rome2/midiswitch/board/MIDI Switch.kicad_pcb

## KiCad design board/MIDI Switch.kicad_pcb (2016-09-18, last stored version)

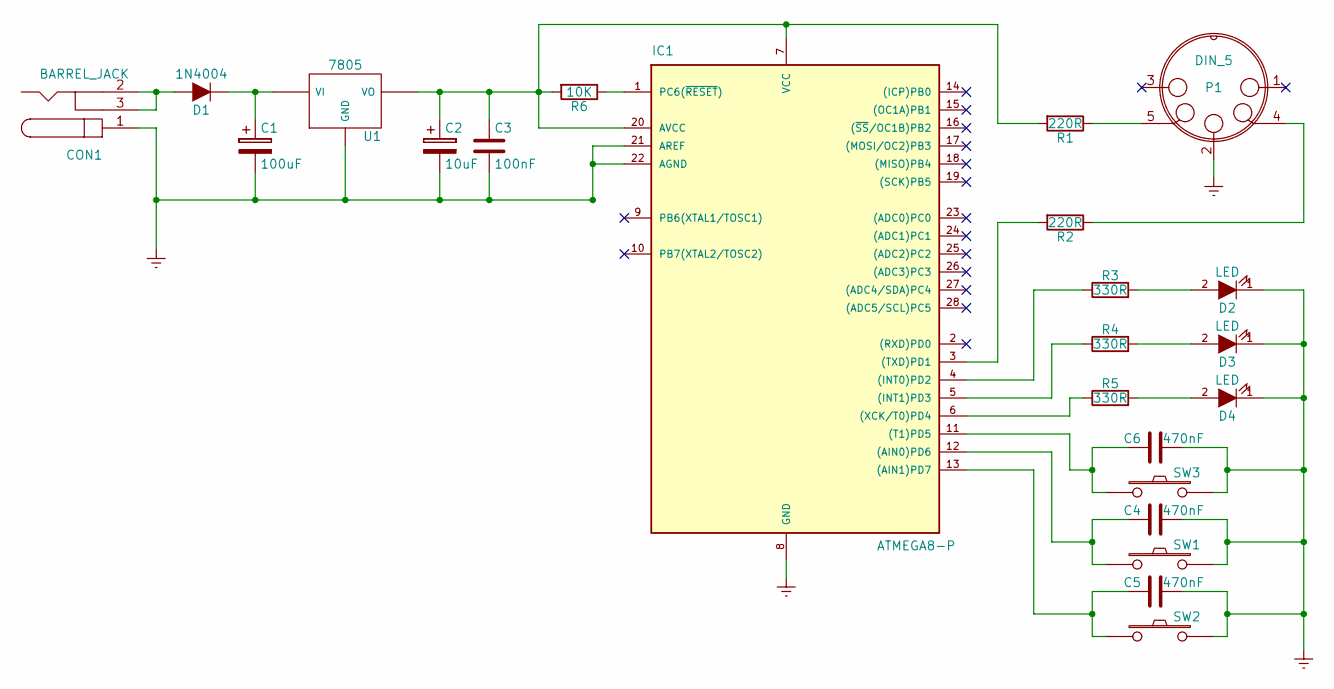
[picture p5: schematic MIDI Switch.sch]

Parts:
C1: 100uF; C_Radial_D8_L13_P3.8
C2: 10uF; C_Radial_D5_L11_P2.5
C3: 100nF; C_Disc_D6_P5
C4, C5, C6: 470nF; C_Disc_D6_P5
CON1: BARREL_JACK
D1: 1N4004; Diode_DO-41_SOD81_Horizontal_RM10
D2, D3, D4: LED; LED-5MM
IC1: ATMEGA8-P; DIP-28_W7.62mm
P1: DIN_5; Pin_Header_Straight_1x05
R1, R2: 220R; Resistor_Horizontal_RM10mm
R3, R4, R5: 330R; Resistor_Horizontal_RM10mm
R6: 10K; Resistor_Horizontal_RM10mm
SW1, SW2, SW3: SW_PUSH
U1: 7805; TO-220

Connections:
GNDREF: C1.2, C2.2, C3.2, C4.2, C5.2, C6.2, CON1.1, D2.1 (K), D3.1 (K), D4.1 (K), IC1.8 (GND), IC1.21 (AREF), IC1.22 (AGND), P1.2, SW1.2, SW2.2, SW3.2, U1.3 (GND)
unnamed: C1.1, D1.1 (K), U1.1 (VI)
unnamed: C2.1, C3.1, IC1.7 (VCC), IC1.20 (AVCC), R1.2, R6.2, U1.2 (VO)
unnamed: C4.1, IC1.12 ((AIN0)PD6), SW1.1
unnamed: C5.1, IC1.13 ((AIN1)PD7), SW2.1
unnamed: C6.1, IC1.11 ((T1)PD5), SW3.1
unnamed: CON1.2, CON1.3, D1.2 (A)
unnamed: D2.2 (A), R3.2
unnamed: D3.2 (A), R4.2
unnamed: D4.2 (A), R5.2
unnamed: IC1.1 (PC6(~RESET~)), R6.1
unnamed: IC1.3 ((TXD)PD1), R2.2
unnamed: IC1.4 ((INT0)PD2), R3.1
unnamed: IC1.5 ((INT1)PD3), R4.1
unnamed: IC1.6 ((XCK/T0)PD4), R5.1
unnamed: P1.4, R2.1
unnamed: P1.5, R1.1

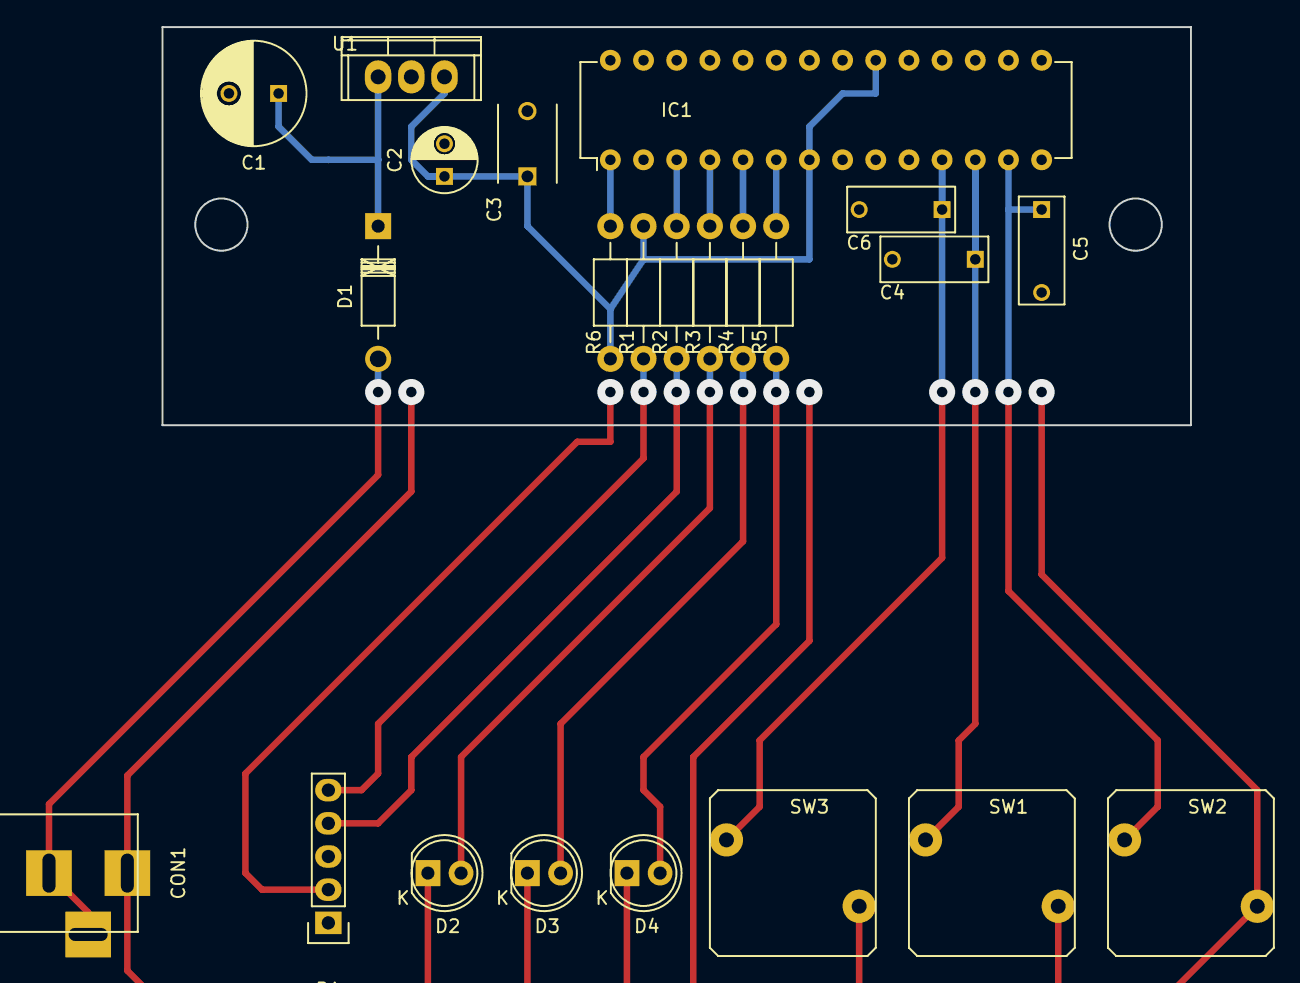
[picture p6: board MIDI Switch.kicad_pcb from above]

Board: 2 copper layers, 23 parts (0 on the bottom side), 17 nets.
