rome2/midiswitch/(commit log)

2016-09-18 Initial setup
    [MIDI Switch.kicad_pcb, MIDI Switch.sch]
2017-02-20 Added print layout
2017-02-22 Swapped button and led order
